robertbedichek/poolpumpcontrol/PoolPumpControl_Schematic.pdf

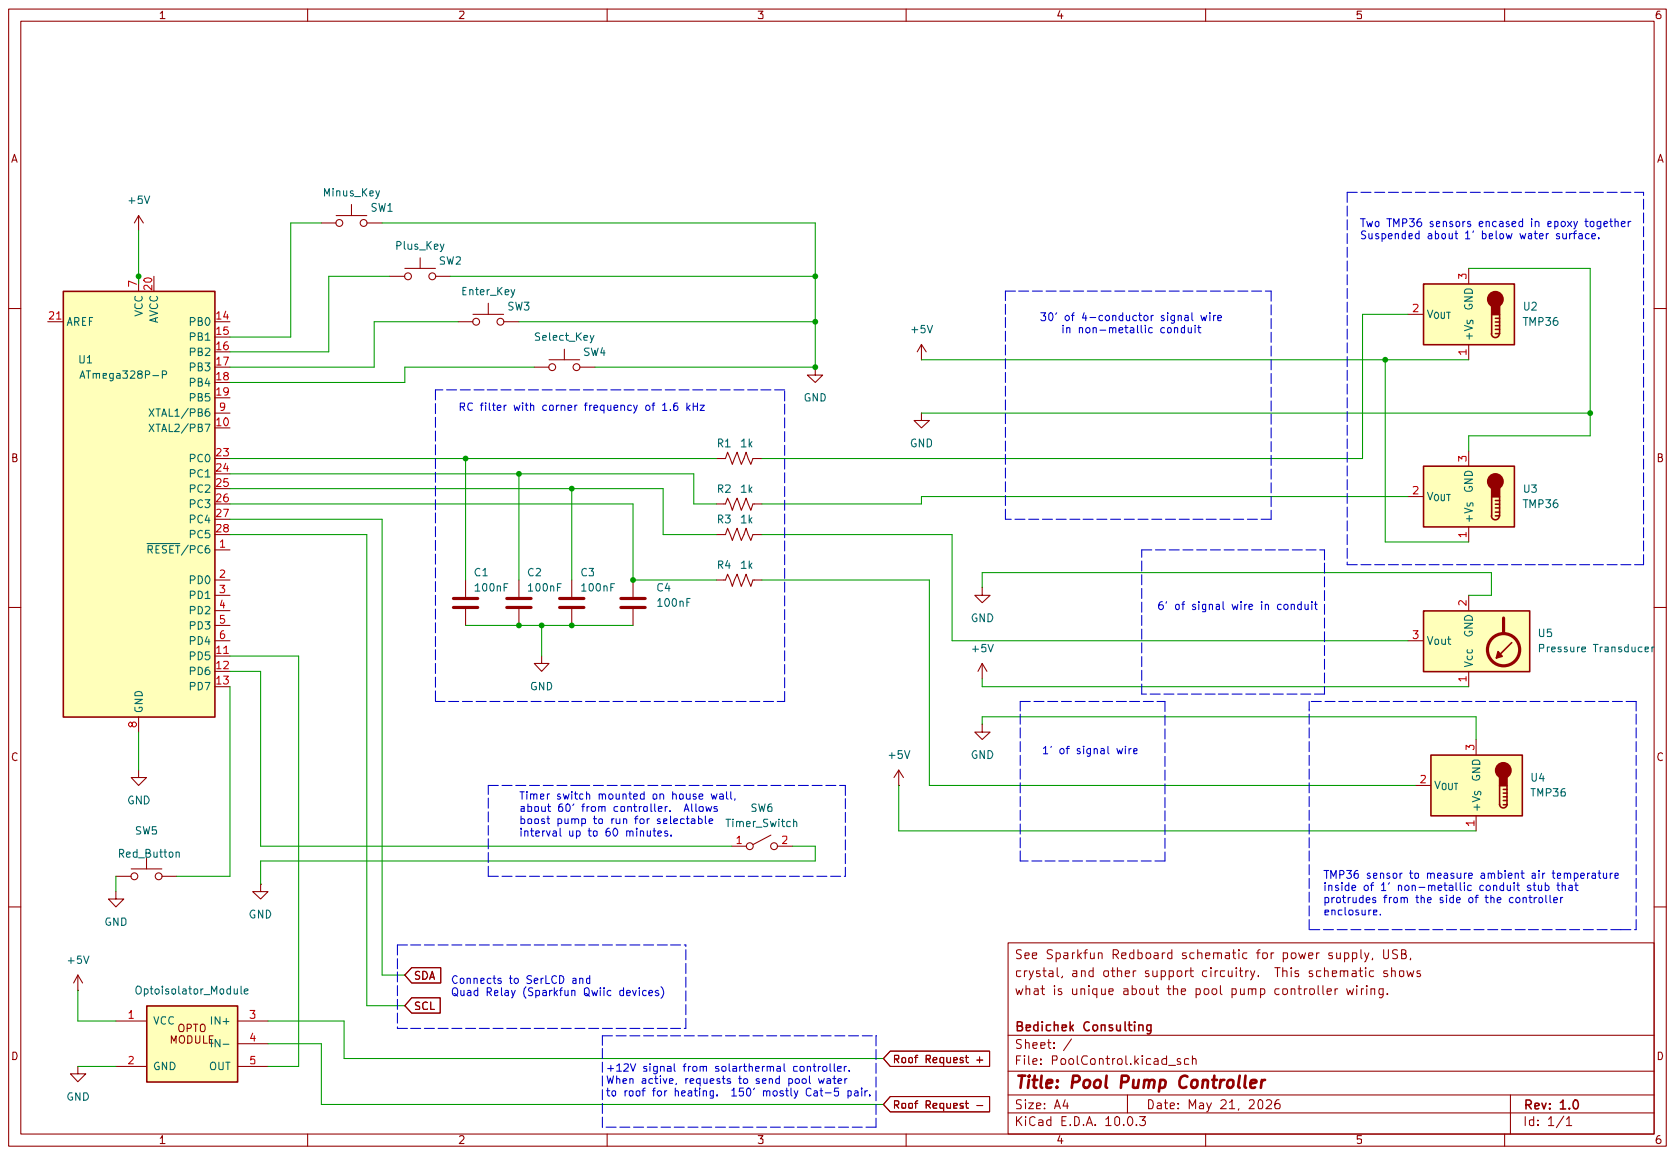
[picture p1: page 1]
