robertbedichek/poolpumpcontrol/gobble_poolpumpcontrol.py

#!/usr/bin/env python3

# This attempt to supress the (harmless) warning about OpenSSL does not work, but leaving it here nonetheles
import warnings
warnings.filterwarnings("ignore", category=UserWarning, module="urllib3")

import serial
import time
import subprocess
import os
import requests
from datetime import datetime
from datetime import date

home_dir = os.path.expanduser("~")
app_token_path = os.path.join(home_dir, ".pushover", "ap_token.txt")
user_token_path = os.path.join(home_dir, ".pushover", "user_token.txt")


with open(app_token_path, "r") as f:
    app_token = f.read().strip()

with open(user_token_path, "r") as f:
    user_token = f.read().strip()

SSH_COMMAND = [
    "/usr/bin/env", "ssh",
    "-i", os.path.expanduser('~/.ssh/id_rsa'),
    "root@bedichek.org",
    "cat >> /var/www/html/home/poolpumpcontrol.txt"
]

# port = "/dev/tty.usbserial-211440"
port = "/dev/tty.usbserial-11240"
baud_rate = 115200

ser = serial.Serial(port, baud_rate, timeout=1)

# Optional: Reset Arduino on start (commented out to preserve state)
# WARNING: Resetting the Arduino loses all state including:
#          - Pump on/off timers
#          - Drain-down progress
#          - Manual pump requests
# Uncomment only if you need to force a clean restart
# ser.setDTR(False)
# time.sleep(1)
# ser.setDTR(True)
linecount = 0

def is_valid_data_line(line):
    if line.startswith("#"):
        return True  # Comment line is always OK

    parts = line.strip().split()
    if len(parts) < 10:
        print("must have at least 10 fields: ", line, " but has only ", len(parts))
        return False  # Must have at least 3 fields

    # Assume 'parts' is a list like ['2025-06-06', '12:34:56'] from Arduino input
    date_part, time_part = parts[0], parts[1]

    try:
      # Parse target time
      target_dt = datetime.strptime(f"{date_part} {time_part}", "%Y-%m-%d %H:%M:%S")
    
      # Get current system time
      system_dt = datetime.now()

      # Calculate the absolute difference in seconds
      delta = abs((system_dt - target_dt).total_seconds())

      # If more than 5 minutes, send correction
      if delta > 300:
        print("Target time is off by more than 5 minutes. Sending correction...")

        # Send time command
        timestamp = f"t {system_dt:%H:%M:%S}"
        ser.write((timestamp + '\n').encode())

        # Send date command
        datestamp = 'd ' + date.today().strftime('%Y-%m-%d')
        ser.write((datestamp + '\n').encode())
      else:
#        print("Target time is within acceptable range.")

        # Try to parse all next 9 fields as floats
        for val in parts[2:10]:
            float(val)

        return True

    except ValueError:
      print("Invalid date/time received from Arduino: " + line)
      return False

    except Exception:
      print("Unable to parse date/time field or remaining fields: " + line)
      return False

print(f"Connected to {port}. Reading data.. \n")

try:
  while True:
    try:
      line = ser.readline().decode('utf-8').strip() 
    except UnicodeDecodeError:
      print("⚠️  Corrupted data skipped:", line)
      line = ""
    if line and is_valid_data_line(line):
      linecount = linecount + 1
      if "alert" in line.lower():
        data = {
            "token": app_token,        # This App's Pushover app token
            "user": user_token,        # My personal user key
            "message": line 
        }

        response = requests.post("https://api.pushover.net/1/messages.json", data=data)

        # Optional: log result
        print(f"Status: {response.status_code}")
        print(f"Response: {response.text}")

      try:
        print(line)
        subprocess.run(SSH_COMMAND, input=(line + "\n").encode("utf-8"), check=True)
      except subprocess.CalledProcessError as e:
        print(f"ssh error: {e}")

except KeyboardInterrupt:
  print(f"Stopping after reading and logging {linecount} lines.")
  ser.close()
