robertbedichek/poolpumpcontrol/(commit log)

2025-05-17 initial commit of gobble_ script for pool pump control telemetry
2025-05-18 gobble_poolpumpcontrol.py now works; added checks for out of range temperatures
2025-05-27 1. Changed from yellow button to timer switch. When timer switch input is closed, the main pump runs and the diverter valve switched to sending water to the roof. If the roof valves are in heat-therm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
    [gobble_poolpumpcontrol.py, poolpumpcontrol.ino]
2025-05-27 copy of HTML/JS for rendering data for solar-thermal, solar-tracker, and pool pump control
2025-05-31 Remove hard-code path to one user's directory, use current user's home directory as path prefix instead.
2025-05-31 Remove hard-coded path to user's home directory for path prefix, use current user's home directory for path prefix instead.
2025-05-31 1. Remove logic for sweep pump as I've decided that we don't need one. Instead, we will use the main pump and have the diverter valve set to send water to the roof. Whether or not the roof valves all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
    [poolpumpcontrol.ino]
2025-05-31 switch from hard-coded path for one user to using /Users/robertbedichek for finding the SSH credentials for sending output to the server
2025-05-31 1. Comment-out backlight control code. Just leave the backlight on all the time. 2. Changed the name of some tasks for clarity 3. Fixed bugs in control of the pump and diverter valve.
    [poolpumpcontrol.ino]
2025-06-01 set Arduino's time at the start and every 1000 lines it outputs
2025-06-01 1. Configured unused pins as INPUT_PULLUP and that cured a sudden loss of function. The controller would fail after maybe a second of execution. 2. Lots of pump on/off logic fixes
    [poolpumpcontrol.ino]
2025-06-02 set date of Arduino along with setting the time
2025-06-02 fix stability problem by adding delay(50) around call to setup LCD (argh Set date/time from build date/time only if we haven't received a 't' and 'd' command over the USB serial link from the host
    [poolpumpcontrol.ino]
2025-06-06 fix new bug with starting pump with diag mode or with red button
    [poolpumpcontrol.ino]
2025-06-07 set poll-keys method (for testing); added diagnostics that toggle unused relays in effort to find source of instability; added comments; got rid of pinchangedinterrupt method
2025-06-07 fix stack overflow due to a function calling itself. Made reference to relay board pointer guarded so that we can run without a relay board
    [poolpumpcontrol.ino]
2025-06-07 Reset the target time and date if it is off by more than five minutes
    [gobble_poolpumpcontrol.py]
2025-06-07 turn off polling of keys (use interrupts), fix pressure calibration value, making not finding LV relay board non fatal
    [poolpumpcontrol.ino]
2025-06-07 add crontab file that snapshots the Arduino output every night
2025-06-08 remove older method for deciding when to reset the Arduino's date and time (it was commented out)
    [gobble_poolpumpcontrol.py]
2025-06-08 improve comments and code clarity around polling vs. using interrupts for the keys; fix to use correct interrupt
    [poolpumpcontrol.ino]
2025-06-10 remove dead backlight timer code; disable high speed I2C mode (hoping for better stability); pass reason strings to pump and valve control functions; remove time-of-day logic to make system more robu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
    [poolpumpcontrol.ino]
2025-06-10 Add schematic for central Arduino board used in this controller
2025-06-13 protect functions that take a pointer to a flash-based string from calls with null pointers. This does not fix any known problem, just defensive programming
    [poolpumpcontrol.ino]
2025-06-13 fix bug with turning off the pump when we should not, e.g., in the case of the pool sweep causing the diverter valve to switch to roof mode
    [poolpumpcontrol.ino]
2025-06-14 fix bug with expressions to calculate milliseconds since the last time the pump was turned on or off
    [poolpumpcontrol.ino]
2025-06-14 Put build date and time on reboot message line. Remove dependence on time of day being set correctly
    [poolpumpcontrol.ino]
2025-10-06 fix path issue that resulted from switch to nginx
    [gobble_poolpumpcontrol.py]
2025-10-06 reduce max pump on time to three hours; add periodic running of pump to filter water if it hasn't run for 24 hours
2025-10-10 fix period pool filtering bug; filter water on startup
    [poolpumpcontrol.ino]
2025-10-19 put boost pump logic back in -- we need the boost pump
2025-10-19 fix various bugs that Claude pointed out
    [poolpumpcontrol.ino]
2025-10-19 added a task for monitoring the boost pump; added defensive logic to protect the boost pump
2025-10-26 condition turning off boost pump after time limit on the boost pump being on
2025-10-27 Fix pool temperature calculation to handle sensor failures correctly
    Previously, when one temperature sensor failed (returned 0°F), the code would average it with the good sensor reading, producing incorrect temperatures (e.g., 0 + 75 = 37.5°F). Now uses only the working sensor when one fails, matching the behavior described in the code comment.
    [poolpumpcontrol.ino]
2025-10-27 Respect drain-down period for red button and timer switch
    Previously, pressing the red button or activating the timer switch would
    immediately turn on the pump, even during the drain-down period when the
    pool piping needs to drain back through the roof valves.
    Now both inputs check if we're in a drain-down period (valve in roof mode,
    no active diverter request, less than 20 minutes since pump stopped) before
    allowing the pump to restart. This allows the solarthermal controller to
    cooperatively drain the pool piping by leaving its roof valves open in pool
    mode for a few minutes.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
2025-10-27 Use explicit SENSOR_ERROR sentinel value instead of 0°F for failed sensors
    Previously used 0°F to indicate sensor failures, which is ambiguous since 0°F
    is a valid temperature. Now uses -999.0°F as a clear sentinel value that
    cannot be confused with actual temperature readings.
    Changes:
    - Define SENSOR_ERROR constant as -999.0
    - Update all temperature sensor error handling to use SENSOR_ERROR
    - Change averaging logic to use exact equality checks (== SENSOR_ERROR)
    - Affects pool_temperature1_F, pool_temperature2_F, and outside_temperature_F
    [poolpumpcontrol.ino]
2025-10-27 Disable Arduino reset on Python script start to preserve state
    Previously, the Python monitoring script reset the Arduino via DTR toggle
    every time it started. This caused loss of all Arduino state including:
    - Pump on/off timers
    - Drain-down progress
    - Manual pump requests
    Now the reset is commented out by default to preserve state across Python
    script restarts. The reset code remains available but documented with
    warnings for situations where a forced clean restart is needed.
    [gobble_poolpumpcontrol.py]
2025-10-27 Add periodic daily boost pump operation (30 minutes per day)
    Previously, the boost pump only ran when the timer switch was activated.
    Now it automatically runs once every 24 hours for 30 minutes to maintain
    pool cleanliness.
    Features:
    - Runs boost pump for 30 minutes once per day
    - Automatically starts main pump if needed
    - Waits for proper pressure (≥5 PSI) before starting
    - Timer switch overrides periodic mode and runs up to 1 hour
    - All existing safety checks remain (pressure, main pump dependency)
    - Clears periodic request if boost pump shuts down due to safety issues
    [poolpumpcontrol.ino]
2025-10-27 turn on boost pump after reboots
    [poolpumpcontrol.ino]
2025-10-27 Display '-' instead of -999°F for failed temperature sensors
    Previously, when temperature sensors failed, the display would show -999°F
    which cluttered the output and could be misinterpreted. Now failed sensors
    display as '-' (dash) for cleaner, more intuitive output.
    - Added format_temperature() helper function
    - Returns ' -' for SENSOR_ERROR, otherwise formatted integer temperature
    - Applied to both LCD display and serial output
    - Maintains consistent 3-character width formatting
    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
    [poolpumpcontrol.ino]
2025-10-27 Add boost pump status to serial telemetry output
    Adds a new "Bst" field to the status output line that shows whether the
    boost pump is on (1) or off (0). This field appears after the main pump
    status and before the diverter valve request field.
2025-10-27 improve boost pump messages
2025-10-27 fix formatting of periodic header, so that column names better line up with the numbers below.
    [poolpumpcontrol.ino]
2025-10-27 Change periodic cleaning to start at noon with specific durations
    - Start periodic cleaning at noon each day instead of 24-hour interval
    - Run main pump for 2 hours during periodic cleaning (was 3 hours max)
    - Run boost pump for 45 minutes during periodic operation (was 30 minutes)
    - Track last periodic filter day to ensure it runs only once per day
    - Add periodic_filter_request flag to distinguish periodic vs manual operation
    - Remove automatic pump startup on reboot (was starting main and boost pumps)
    - Allow periodic cleaning to trigger at noon after reboot if before noon
    [poolpumpcontrol.ino]
2025-10-29 fix boost pump logic so that it now turns on when the main pump turns on for periodic filtering; fixed diagnostic messages
    [poolpumpcontrol.ino]
2026-04-19 1. Update device file name based on how the USB transceivers are plugged into the Mac Mini now 2. Updated plist file to use log files that have unique names (from the other plist files for telemetry 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
2026-05-14 1. Now on reading temperatures and pressure, take a number of samples, sort them, and take the average of the middle values, ignoring the top few and bottom few samples. This may be unnecessary now d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
    [poolpumpcontrol.ino]
2026-05-20 1. Removed dead backlight code
    2. Changed some variables from int to float to gain tiny bit of accuracy in temperature calculations
    3. Added "force_telemetry" global and use this to force output whenever a command is received (e.g., setting date or time, to see the effect immediatly and to ensure that after the telemetry-receiving Python code swallows an out-of-time record, that another record with the right time is emitted by the Arduino and forwarded by the Python code).
    4. Removed some dead variables.
    5. Adjusted the comparisons with SENSOR_ERROR to be more sensible
    6. Adjusted the zero-pressure voltage so that the pressure sensor reports 0 PSI when the pressure is zero.
2026-05-21 1. Update gobble script to emit better diagnostics and to not throw an error when it sees a non numberic value
    2. We now emit as the last field of the telemetry the reason for the last Arduino reset
    3. Fixed bug with force_telemetry, it is now a counter
    [gobble_poolpumpcontrol.py, poolpumpcontrol.ino]
2026-05-22 New schematic of wiring
2026-05-22 update pool pressure calibration factor
2026-05-22 add per-sensor calibration values for the two pool sensors
2026-08-20 fixed logic bug that resulted in turning the main pump off too early
    [poolpumpcontrol.ino]
2026-09-28 around midnight turn off the main pool pump if it is on; append the reboot reason character to the telemetry output lines
    [poolpumpcontrol.ino]
2026-09-28 Remove Safe mode
    Safe mode left outputs running (e.g. the main pump) with no timeout and
    none of Normal mode's logic, so it wasn't safe. The diagnostic modes
    remain; Select now cycles Normal, Main P, Boost, 24 VAC, Divert.
    Telemetry mode numbers for the diagnostic modes shift down by one.
